bemielison/CS5463_ESP8266_Medicao_Energia/DSC_0370.JPG

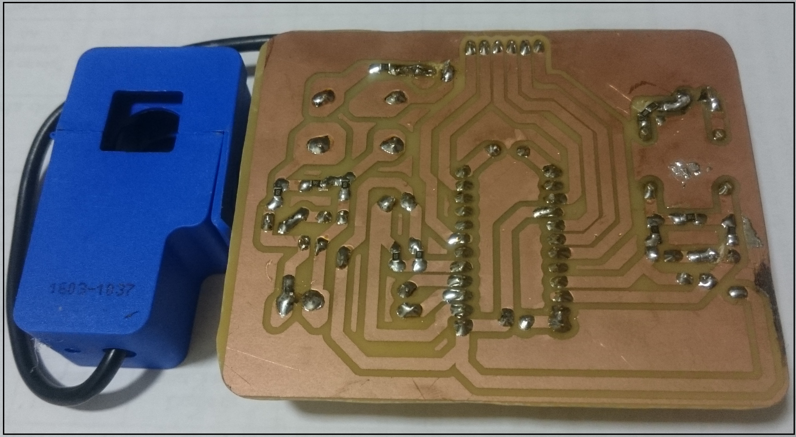
DSC_0370.JPG
