bemielison/CS5463_ESP8266_Medicao_Energia/implementação node-REd.jpg

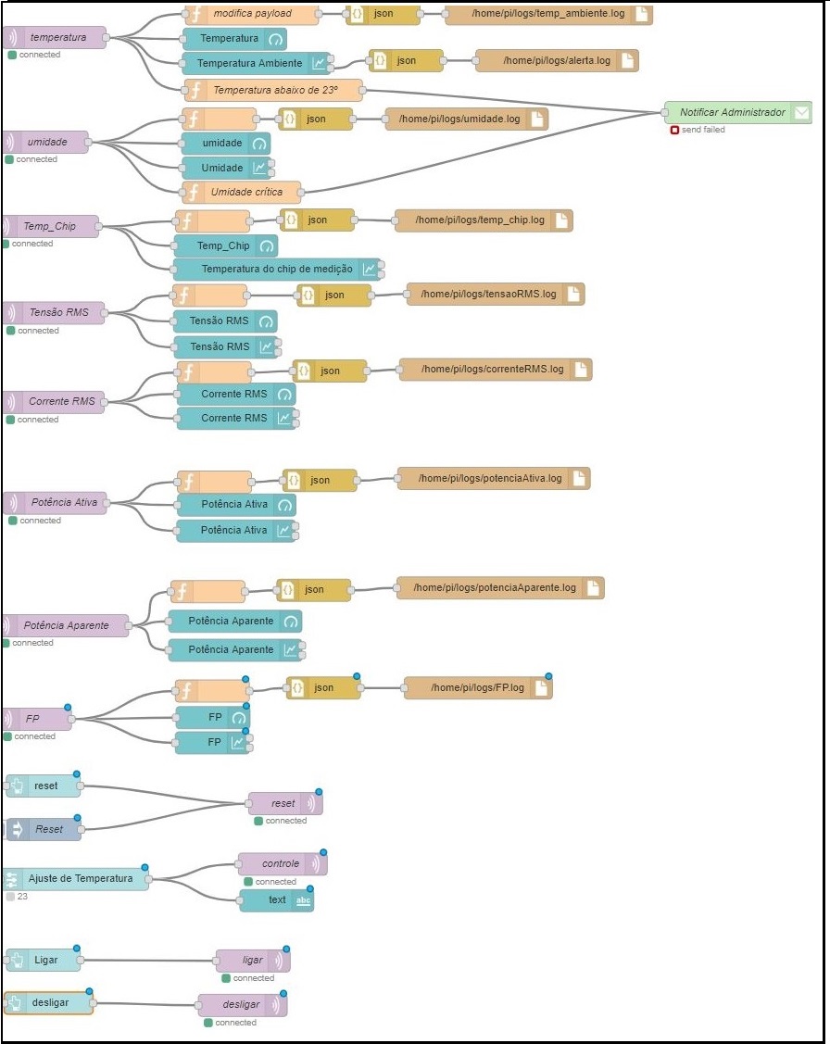
implementação node-REd.jpg
