bemielison/CS5463_ESP8266_Medicao_Energia/a.JPG

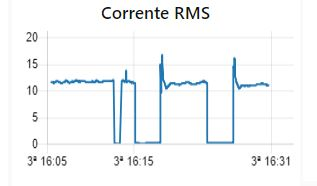
a.JPG
