bemielison/CS5463_ESP8266_Medicao_Energia/ativa e aparente.JPG

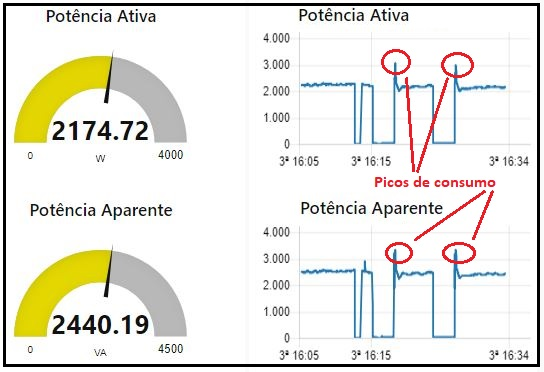
ativa e aparente.JPG
