bemielison/CS5463_ESP8266_Medicao_Energia/c.JPG

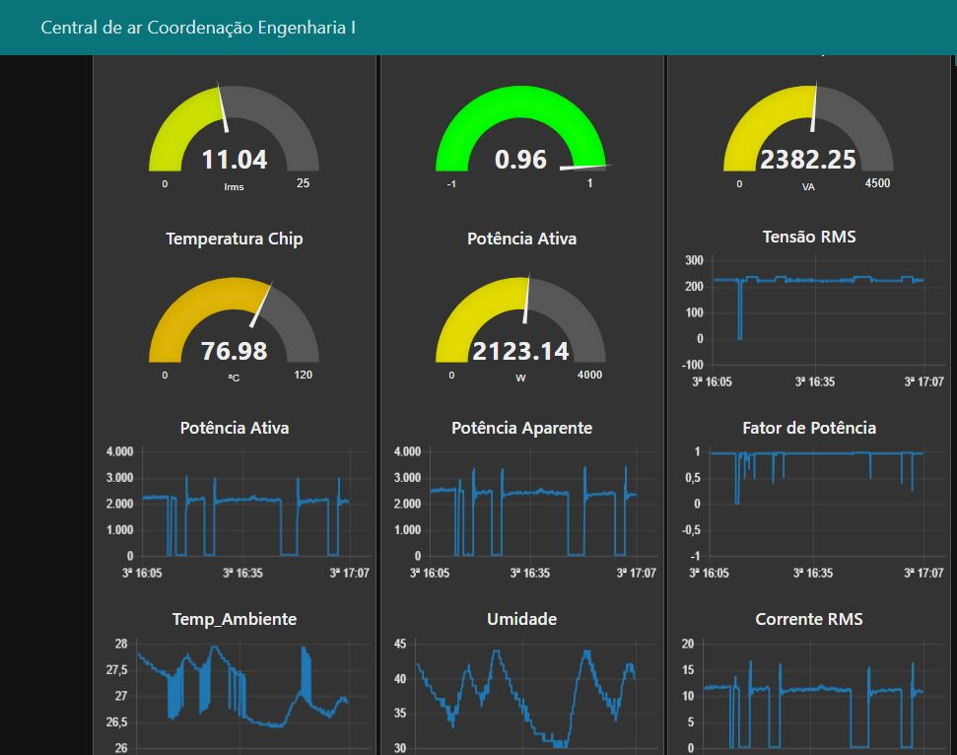
c.JPG
