bemielison/CS5463_ESP8266_Medicao_Energia/Capturar2.JPG

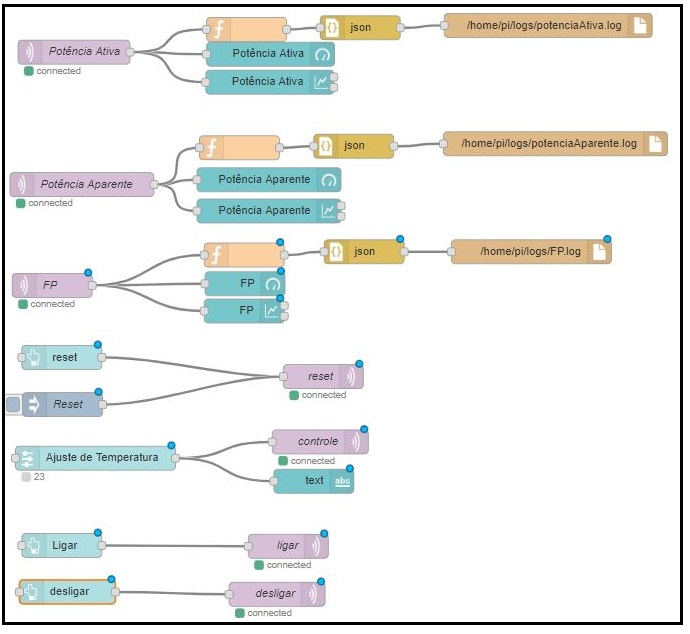
Capturar2.JPG
