bemielison/CS5463_ESP8266_Medicao_Energia/Capturar3.JPG

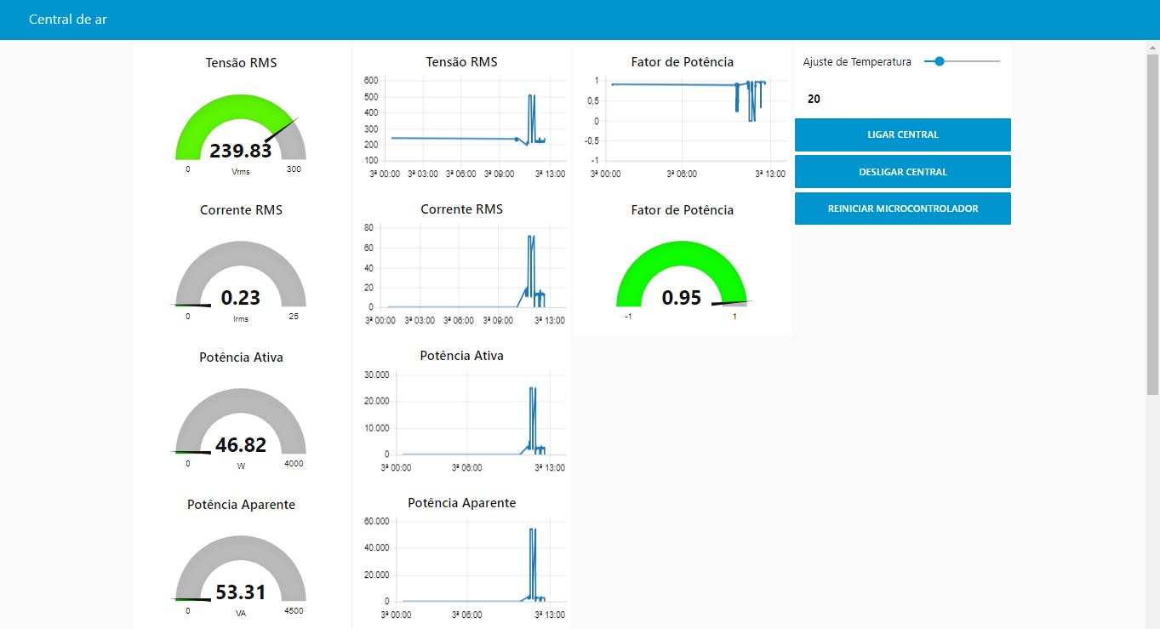
Capturar3.JPG
