bemielison/CS5463_ESP8266_Medicao_Energia/Capturar4.JPG

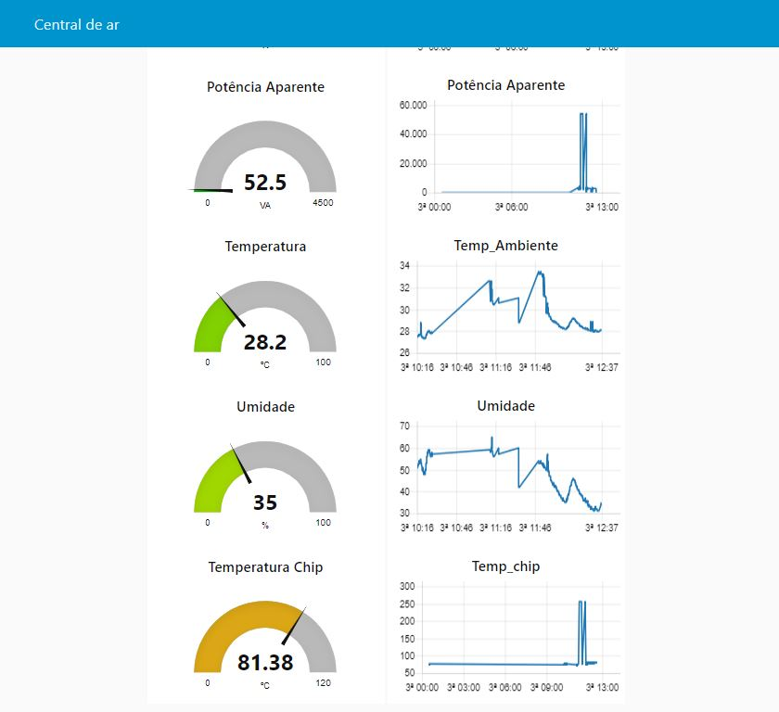
Capturar4.JPG
