bemielison/CS5463_ESP8266_Medicao_Energia/Capturar.JPG

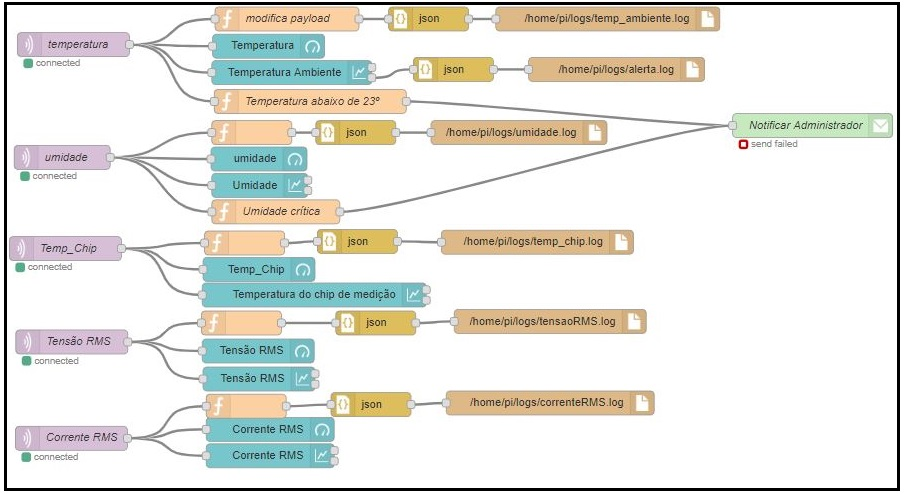
Capturar.JPG
