bemielison/CS5463_ESP8266_Medicao_Energia/dashboard2.JPG

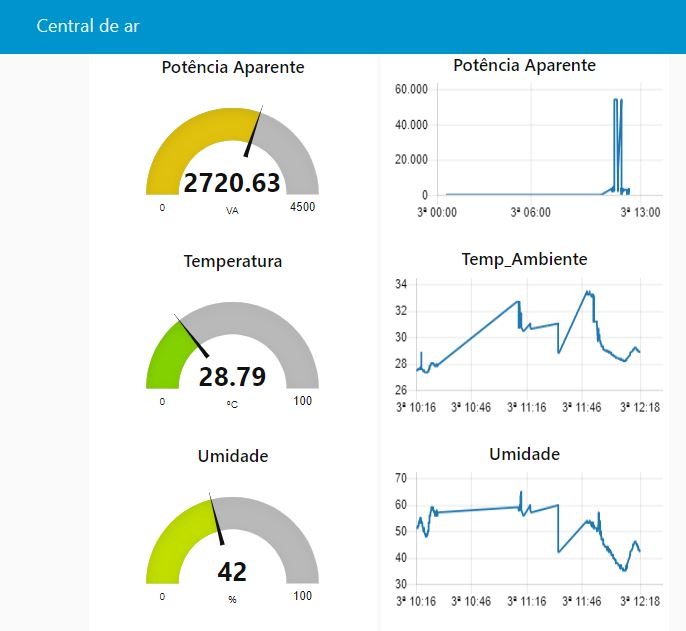
dashboard2.JPG
