bemielison/CS5463_ESP8266_Medicao_Energia/dashboard3.JPG

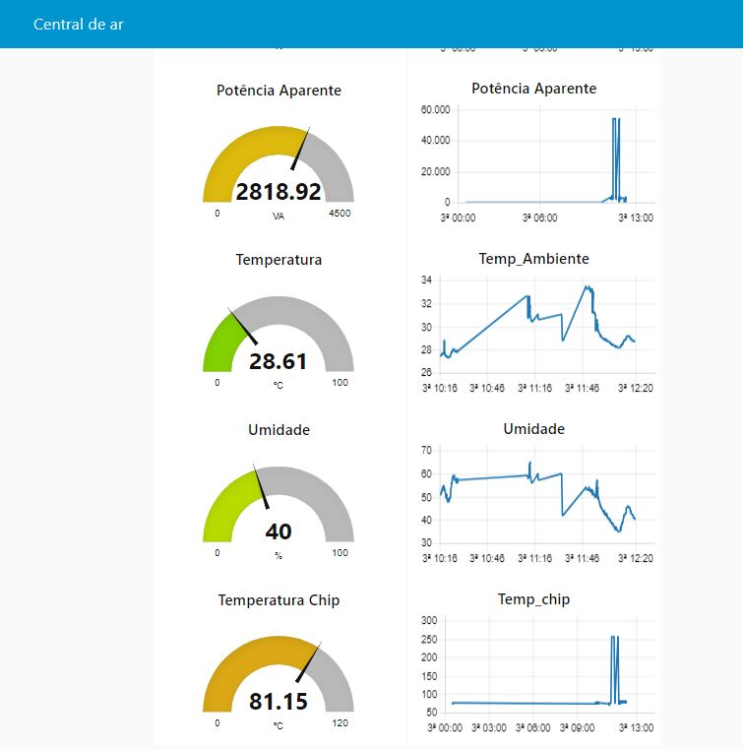
dashboard3.JPG
