bemielison/CS5463_ESP8266_Medicao_Energia/dashboard.JPG

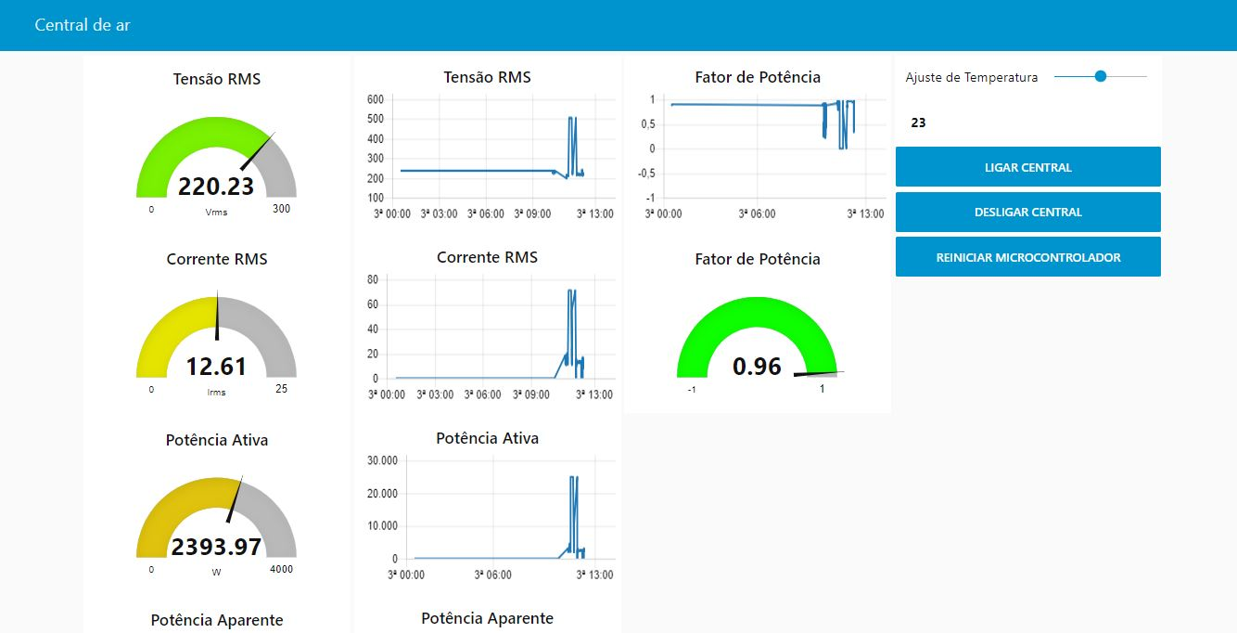
dashboard.JPG
