bemielison/CS5463_ESP8266_Medicao_Energia/DSC_0364.JPG

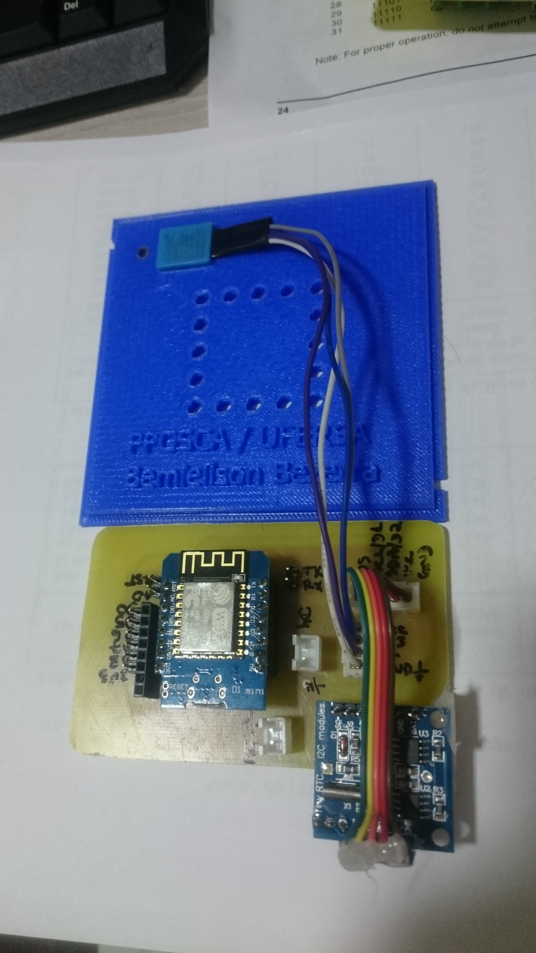
DSC_0364.JPG
