bemielison/CS5463_ESP8266_Medicao_Energia/DSC_0365.JPG

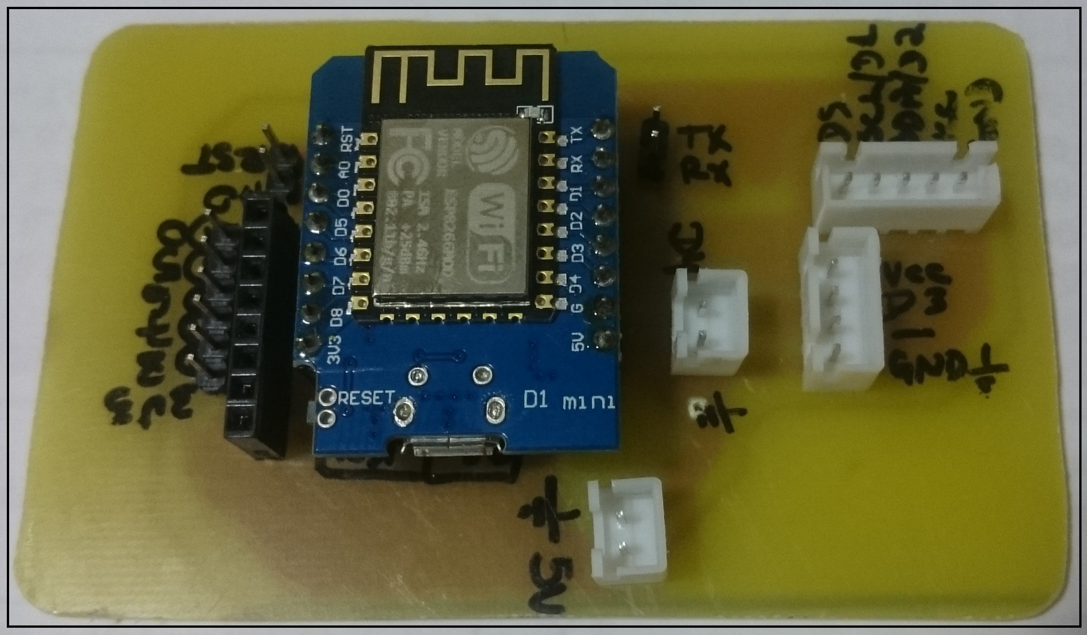
DSC_0365.JPG
