bemielison/CS5463_ESP8266_Medicao_Energia/DSC_0366.JPG

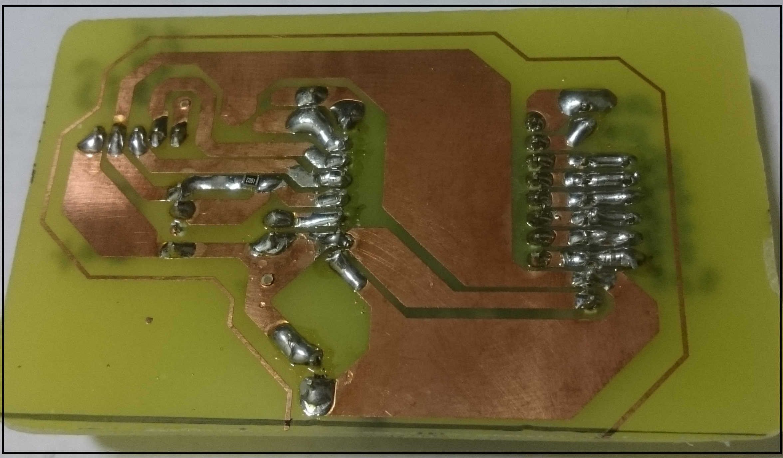
DSC_0366.JPG
