bemielison/CS5463_ESP8266_Medicao_Energia/DSC_0368.JPG

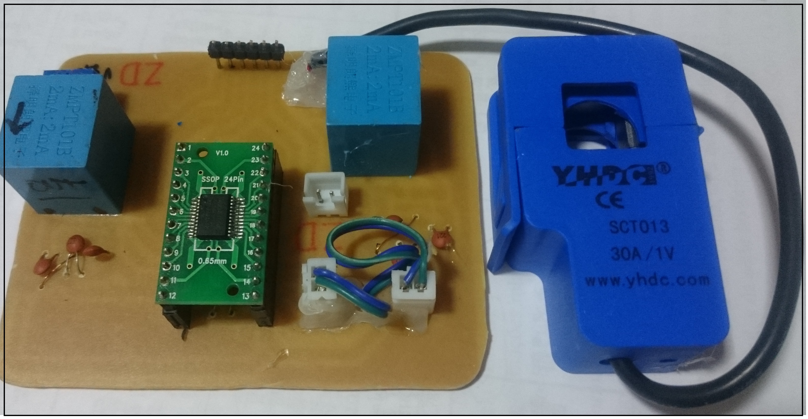
DSC_0368.JPG
