bemielison/CS5463_ESP8266_Medicao_Energia/DSC_0372.JPG

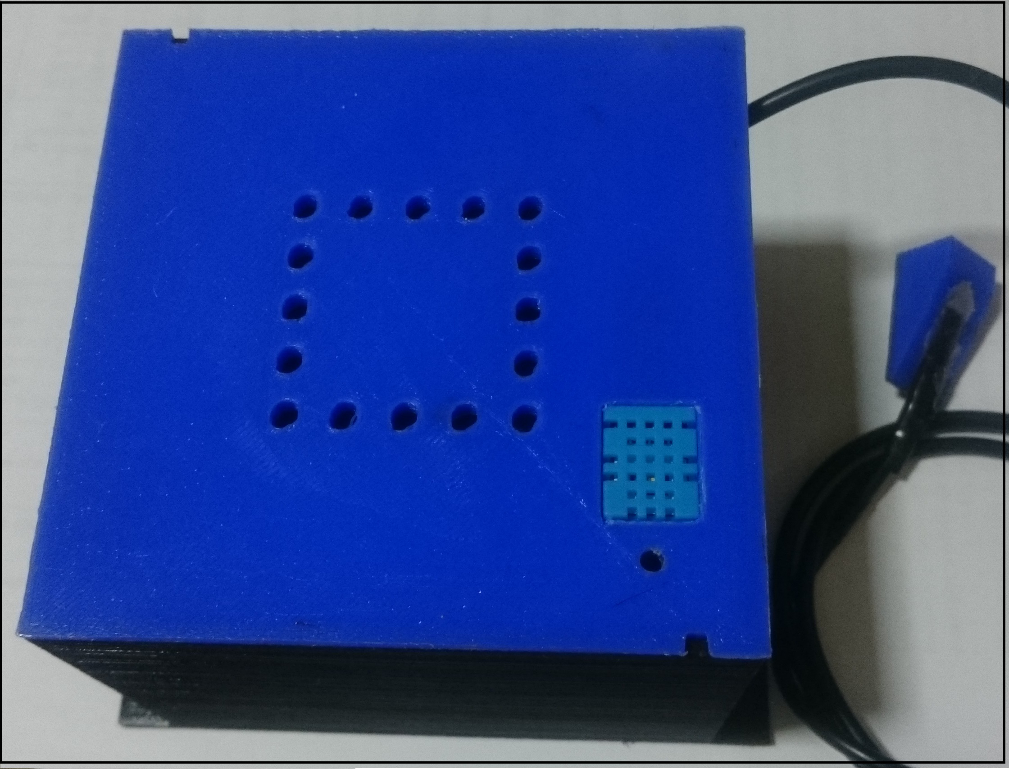
DSC_0372.JPG
