bemielison/CS5463_ESP8266_Medicao_Energia/DSC_0431.JPG

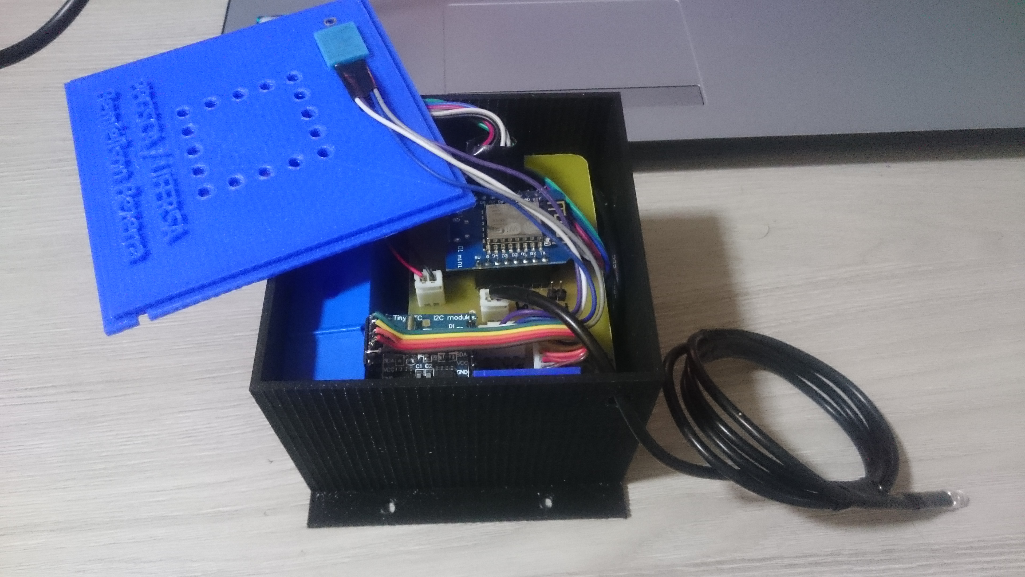
DSC_0431.JPG
