bemielison/CS5463_ESP8266_Medicao_Energia/esquemático placa de medição.JPG

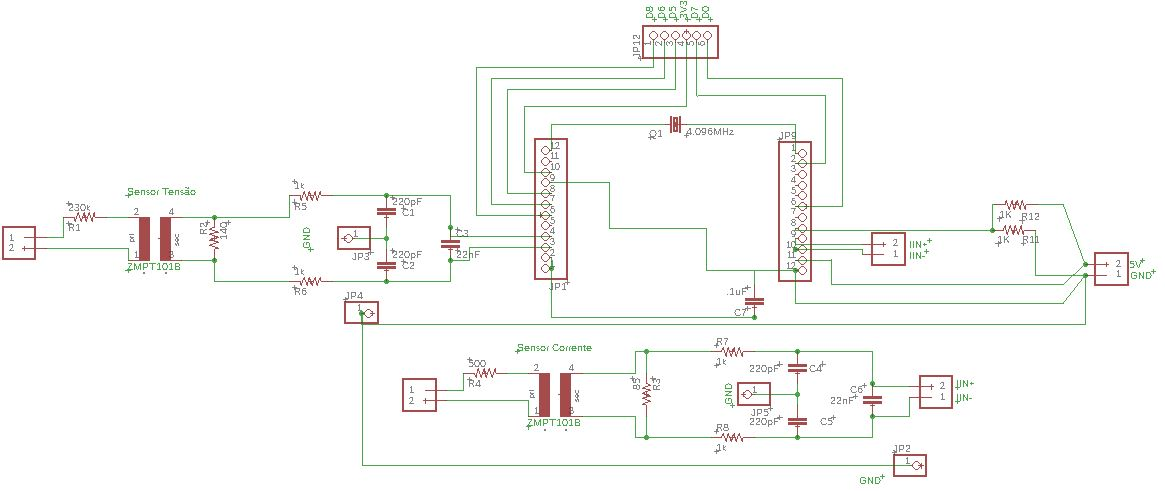
esquemático placa de medição.JPG
