bemielison/CS5463_ESP8266_Medicao_Energia/grafico corrente.JPG

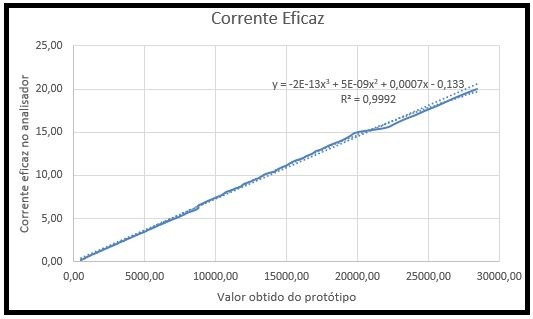
grafico corrente.JPG
