bemielison/CS5463_ESP8266_Medicao_Energia/grafico tensão.JPG

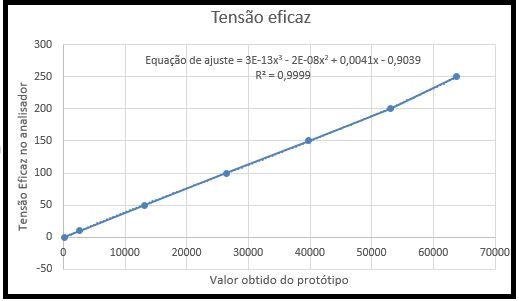
grafico tensão.JPG
