bemielison/CS5463_ESP8266_Medicao_Energia/(commit log)

2019-05-23 Arquivos do projeto implementado na IDE Arduino
2019-05-23 Arquivos IDE Arduino
    Este arquivo compactado contém a pasta com os arquivos .ino da IDE arduino.
